Phobos132/PhobGCC-HW/README.md

# PhobGCC-HW
NOTE: This repository is not currently being mantained, has been moved to: https://github.com/PhobGCC

***

This is the legacy repository for the hardware used in the PhobGCC
