Phobos132/PhobGCC-HW/(threads)

Thread 3 (2022-04-14):

Check resetDefaults

Phobos132, 2022-04-14:
Check resetDefaults for bugs and clean/comment (I think there's a small issue in there somewhere that makes the analog stick behave strangely after the board is reset for the first time)

Closed 2022-04-14.

Thread 5 (2022-04-17):

Rotate top and bottom d-pad footprints 90 degrees

CarVac, 2022-04-17:
I suspect this should reduce inconsistency issues on at least those buttons on the d-pad.

This is because the way the d-pad itself presses down on the rubber domes likely causes initial contact to be near the outside edge of the pad. In the current orientation, this means you have to press a good deal before the rubber smushes enough to make contact with both pads on the pcb.
